trozamon/eecs373-project/doc/system.tex

\documentclass{article}

\usepackage{fullpage}
\usepackage{graphicx}
\usepackage{mathtools}

\begin{document}

\title{Green$^2$ Thumb System Design}
\author{
    Jason Leung\\
    Christopher Oo\\
    Jacob Perrin\\
    Alec Ten Harmsel
}
\date{}
\maketitle

\section{Power}
Power is provided by a bank of capacitors, charged by a solar cell. For the
purposes of planning, the following characteristics are assumed:

\begin{itemize}
    \item 66mW Power Draw: Nordic MCU + BLE Combo (33mW) and miscellaneous
        other power draws
    \item 10uA solar cell current
    \item 100ms runtime
\end{itemize}

\subsection{Maths}
Assuming 66mWs, or $6.6\cdot10^{-3}$J, of energy are needed to take a
measurement and send it, the amount of capacitance is given by: \begin{align*}
    U & = \frac{1}{2}CV^2\\
    1.32 \cdot 10^{-2} & = CV^2
\end{align*}

With 8V storage, we need 300$\mu$F of capacitance to be on the safe side.

The charging time can be found by manipulating the standard capacitor equation
thingy: \begin{align*}
    i & = C\frac{dv}{dt}\\
    it & = Cv\\
    t & = \frac{Cv}{i}
\end{align*}

It's about 141 seconds, or 2.35 minutes.

\begin{itemize}
    \item LMT84DCKT
\end{itemize}

\end{document}
