trozamon/eecs373-project/(list of files, cad)

Other CAD files:
enclosure/EnclosureBottom.CATPart
enclosure/EnclosureTop.CATPart
