trozamon/eecs373-project/kicad/power.kicad_pcb

## KiCad design kicad/power.kicad_pcb (2014-12-03)

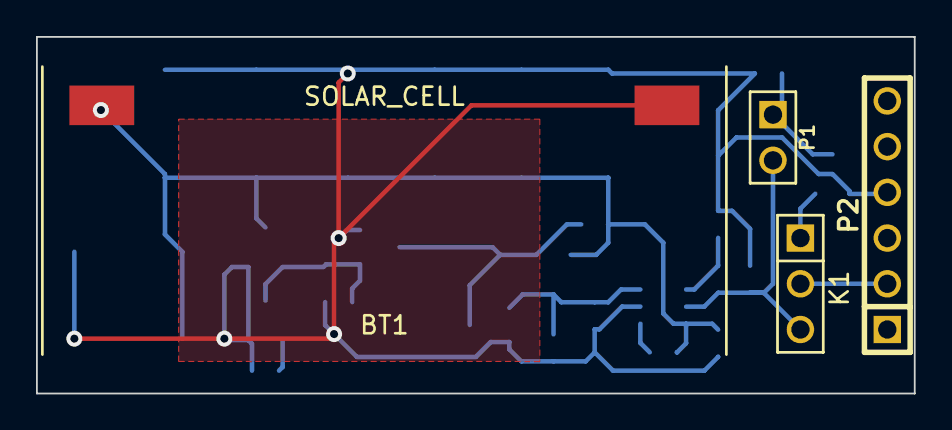
[picture p3: board power.kicad_pcb from above]

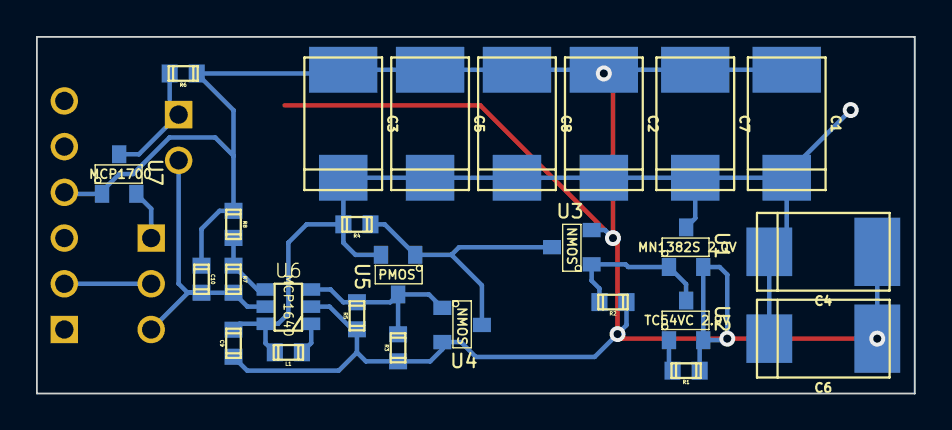
[picture p4: board power.kicad_pcb from below]

Board: 2 copper layers, 48.8 x 19.8 mm, 30 parts (26 on the bottom side), 12 nets.

Parts:
BT1: SOLAR_CELL; AM-1417
C1, C2, C3, C4, C5, C6, C7, C8: 100u; c_tant_D
C9: 4.7u; c_0603
C10: 10u; c_0603
K1: VSEL; PIN_ARRAY_3X1
L1: 4.7u; c_0603
P1: 1V8_EN; PIN_ARRAY_2X1
P2: CONN_6; PIN_ARRAY-6X1
R1: 1k; c_0603
R2: 100k; c_0603
R3, R4, R5, R6: 470k; c_0603
R7: 976k; c_0603
R8: 562k; c_0603
U1: MN1382S 2.0V; SOT23
U2: TC54VC 2.9V; SOT23
U3, U4: NMOS; SOT23
U5: PMOS; SOT23
U6: MCP1640; SOT23_6
U7: MCP1700; SOT23

Connections:
GND: BT1.2, C1.2, C2.2, C3.2, C4.2, C5.2, C6.2, C7.2, C8.2, C9.2, C10.2, P2.4, R1.2, R2.2, R3.2, R5.2, R6.2, R8.2, U1.2, U2.2, U3.2, U4.2, U6.2, U7.1
unnamed: C10.1, K1.3, P1.2, R7.1, U6.5
unnamed: K1.2, P2.2
unnamed: K1.1, U7.2
unnamed: R3.1, R5.1, U4.1, U5.3, U6.3
unnamed: L1.2, U6.1
unnamed: R7.2, R8.1, U6.4
unnamed: P1.1, R6.1, U7.3
unnamed: BT1.1, C1.1, C2.1, C3.1, C4.1, C5.1, C6.1, C7.1, C8.1, C9.1, L1.1, R4.1, U1.3, U5.2, U6.6
unnamed: R1.1, U2.1
unnamed: R2.1, U1.1, U2.3, U3.1
unnamed: R4.2, U3.3, U4.3, U5.1
