trozamon/eecs373-project/eagle/soil_mite_v1.brd

## EAGLE design eagle/soil_mite_v1.brd (2014-11-23)

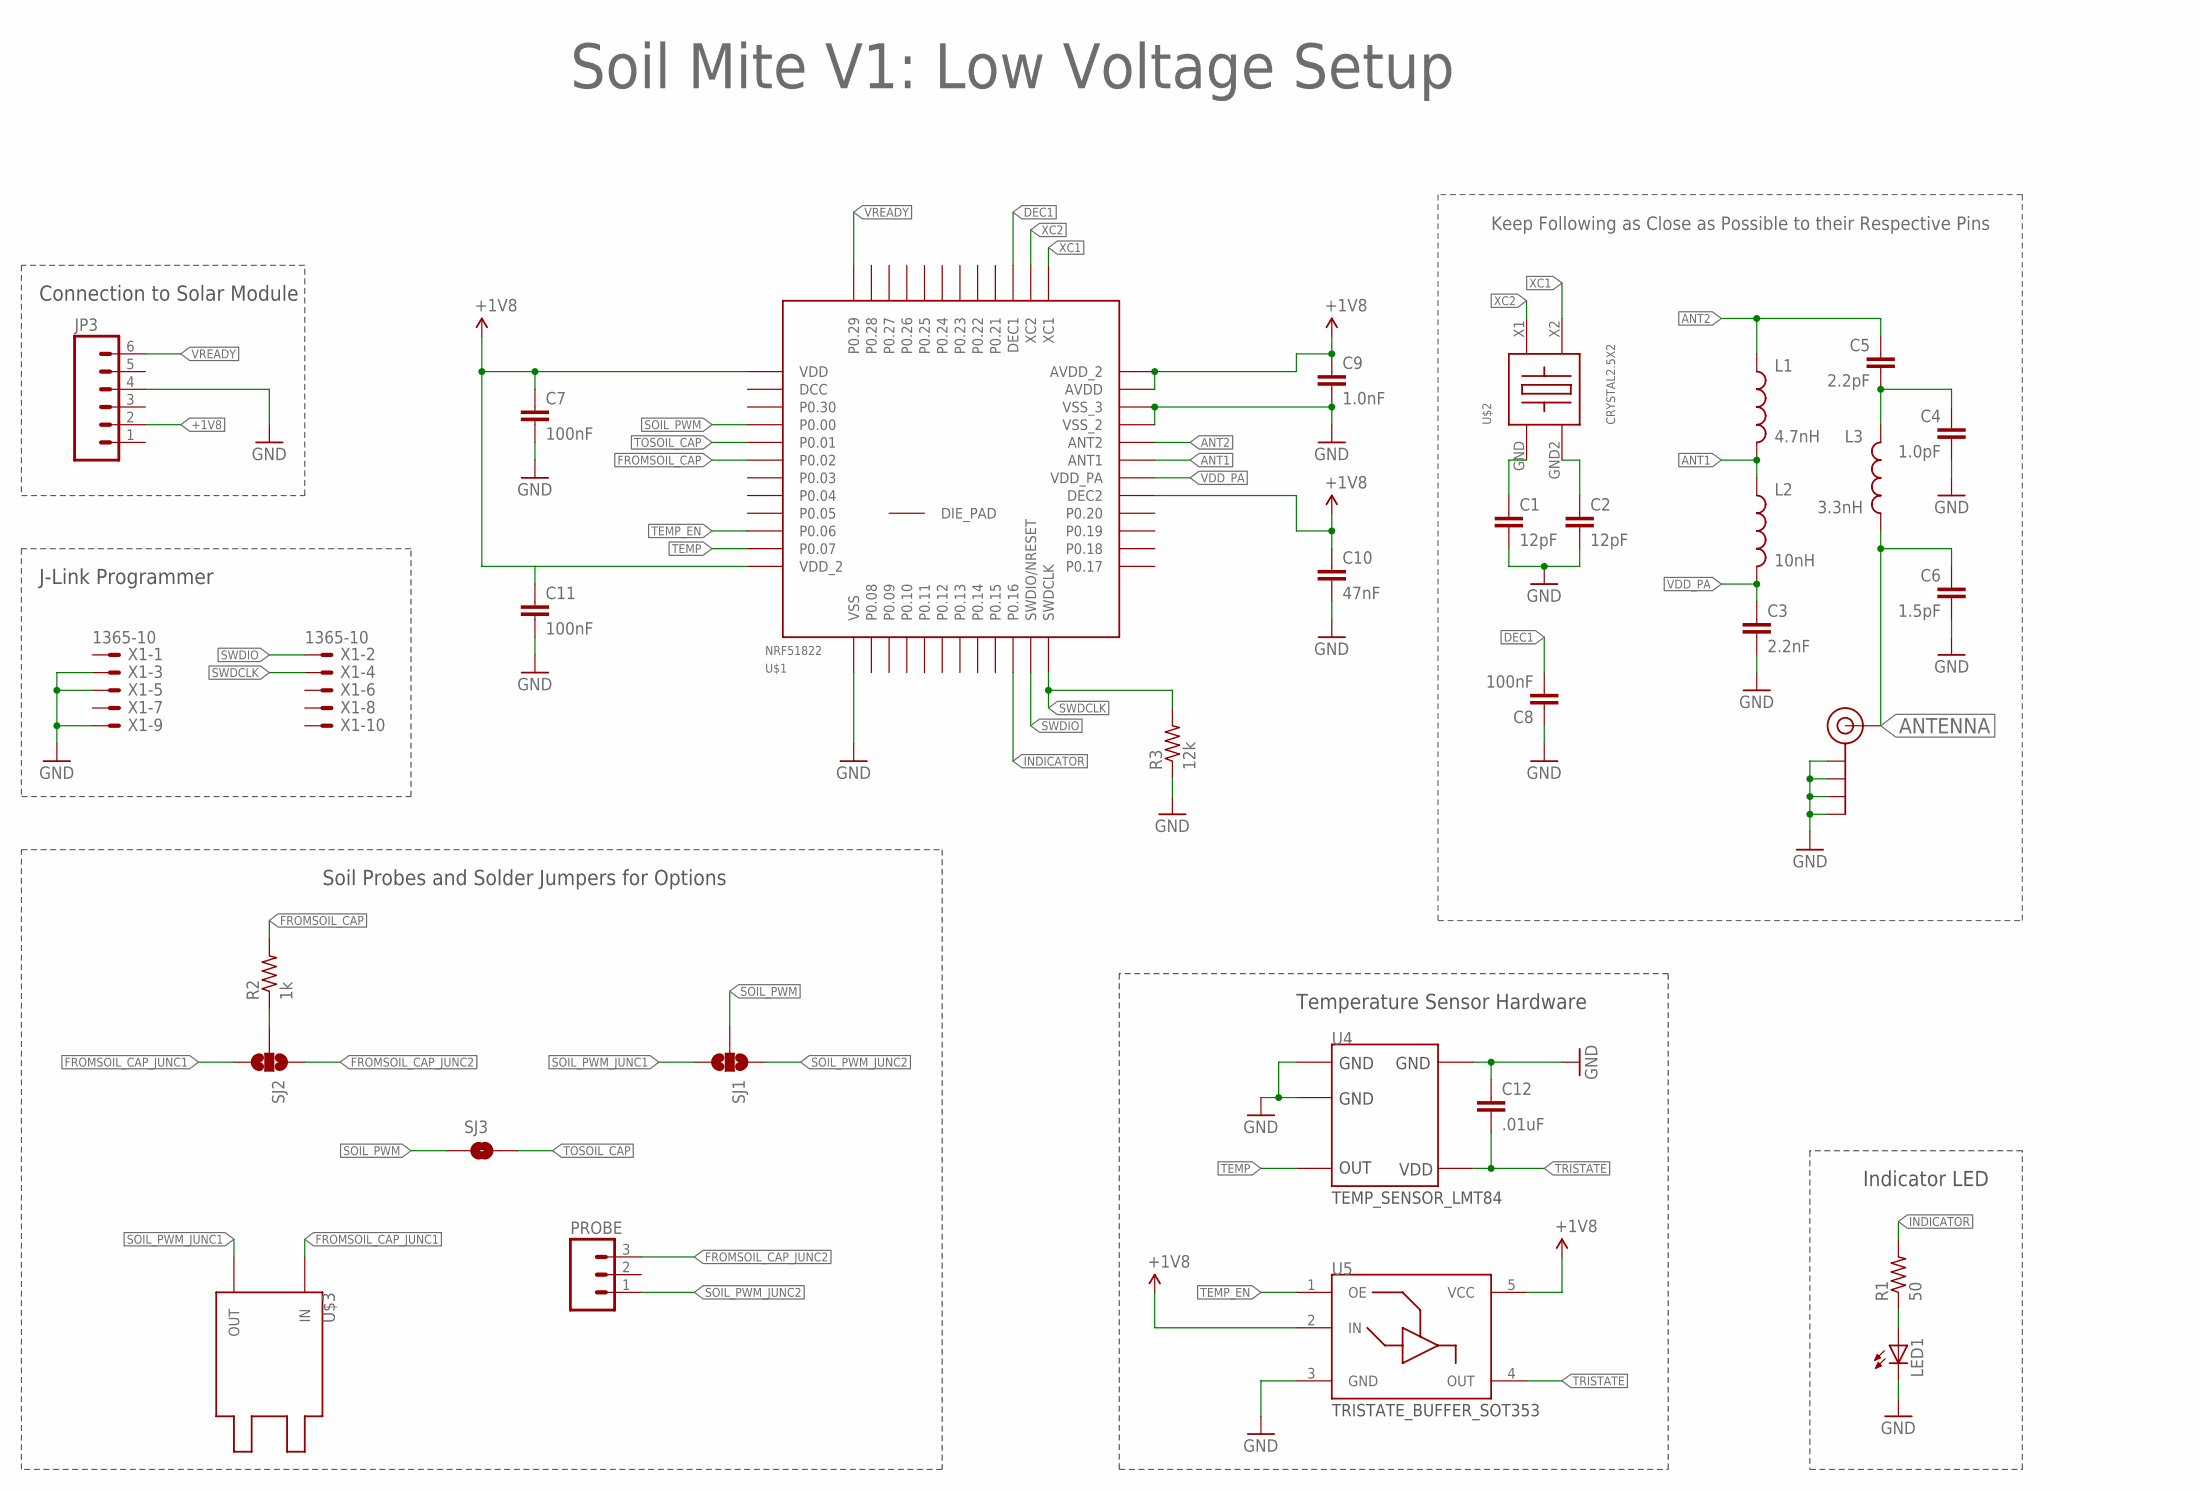
[picture p5: schematic soil_mite_v1.sch]

Parts:
C1, C2: 12pF; 0402-CAP
C3: 2.2nF; 0402-CAP
C4: 1.0pF; 0402-CAP
C5: 2.2pF; 0402-CAP
C6: 1.5pF; 0402-CAP
C7, C8, C11: 100nF; 0402-CAP
C9: 1.0nF; 0402-CAP
C10: 47nF; 0402-CAP
C12: .01uF; 0402-CAP
J$1: SMA_EDGE; SMA-EDGE
JP3: M06POLAR; MOLEX-1X6
L1: 4.7nH; C0402
L2: 10nH; C0402
L3: 3.3nH; C0402
LED1: JON_LIB_LEDCHIPLED_0603; JON_LIB_CHIPLED_0603
PROBE: M03PTH; 1X03
R1: 50; R0603
R2: 1k; R0603
R3: 12k; RCL_R0402
SJ1, SJ2: SOLDERJUMPER_2WAYT; SJ_2
SJ3: SOLDERJUMPERNO; SJ_2S-NO
U4: TEMP_SENSOR_LMT84; SOT353
U5: TRISTATE_BUFFER_SOT353; SOT353
U$1: NRF51822; QFN48
U$2: CRYSTAL2.5X2; 2.5X2MM
U$3: SOIL_PROBE_TOP_TOPOUT-IN; PROBE_LAYOUT_1_OUT-IN
X1: 1365-10

Connections:
+1V8: C7.1, C9.1, C10.1, C11.1, JP3.2, U5.2 (IN), U5.5 (VCC), U$1.1 (VDD), U$1.12 (VDD_2), U$1.29 (DEC2), U$1.35 (AVDD), U$1.36 (AVDD_2)
ANT1: L1.2, L2.1, U$1.31 (ANT1)
ANT2: C5.1, L1.1, U$1.32 (ANT2)
ANTENNA: C6.1, J$1.SIG (SIGNAL), L3.2
DEC1: C8.2, U$1.39 (DEC1)
FROMSOIL_CAP: R2.1, R2.2, SJ2.2, U$1.6 (P0.02)
FROMSOIL_CAP_JUNC1: SJ2.3, U$3.IN
FROMSOIL_CAP_JUNC2: PROBE.3, SJ2.1
GND: C1.2, C2.2, C3.2, C4.2, C6.2, C7.2, C8.1, C9.2, C10.2, C11.2, C12.1, J$1.GND@0 (GND), J$1.GND@1 (GND), J$1.GND@2 (GND), J$1.GND@3 (GND), JP3.4, LED1.C, R3.1, U4.1 (GND), U4.2 (GND), U4.5 (GND), U5.3 (GND), U$1.13 (VSS), U$1.33 (VSS_2), U$1.34 (VSS_3), X1.3, X1.5, X1.9
INDICATOR: R1.2, U$1.22 (P0.16)
unnamed: C1.1, U$2.GND
unnamed: C2.1, U$2.GND2
unnamed: LED1.A, R1.1
unnamed: C4.1, C5.2, L3.1
SOIL_PWM: SJ1.2, SJ3.1, U$1.4 (P0.00)
SOIL_PWM_JUNC1: SJ1.3, U$3.OUT
SOIL_PWM_JUNC2: PROBE.1, SJ1.1
SWDCLK: R3.2, U$1.24 (SWDCLK), X1.4
SWDIO: U$1.23 (SWDIO/NRESET), X1.2
TEMP: U4.3 (OUT), U$1.11 (P0.07)
TEMP_EN: U5.1 (OE), U$1.10 (P0.06)
TOSOIL_CAP: SJ3.2, U$1.5 (P0.01)
TRISTATE: C12.2, U4.4 (VDD), U5.4 (OUT)
VDD_PA: C3.1, L2.2, U$1.30 (VDD_PA)
VREADY: JP3.6, U$1.48 (P0.29)
XC1: U$1.37 (XC1), U$2.X2
XC2: U$1.38 (XC2), U$2.X1

Notes on the sheet:
Soil Mite V1: Low Voltage Setup
Keep Following as Close as Possible to their Respective Pins
Connection to Solar Module
J-Link Programmer
Soil Probes and Solder Jumpers for Options
Temperature Sensor Hardware
Indicator LED

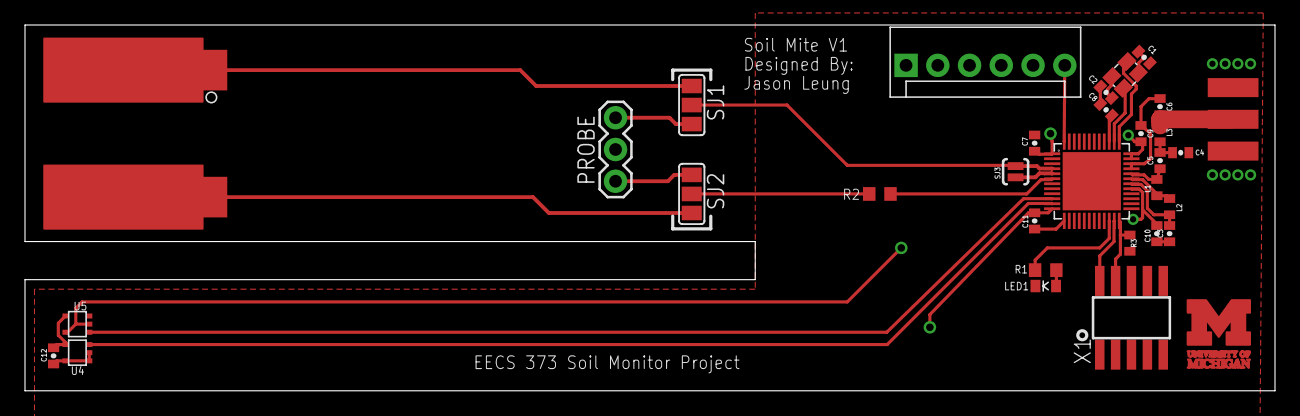
[picture p6: board soil_mite_v1.brd from above]

Board: 4 copper layers, 100.0 x 29.3 mm, 32 parts (0 on the bottom side), 27 nets.

Other parts of the board:
U$5: BLOCK-M-DOUBLE-STACKED-5MM_MASK
