trozamon/eecs373-project/(commit log)

2014-11-16 Add power circuit schematic
    [power.sch]
2014-11-21 Update power schematic
    [power.sch]
2014-11-21 Add temp sensor to system docs
2014-11-21 added completed schematic but incomplete board. if you need explanations of parts of the board feel free to ping me
    [soil_mite_v1.brd, soil_mite_v1.sch]
2014-11-21 Finish schematic, assigning footprints
    [power.sch]
2014-11-21 Finish power component to footprint mapping
2014-11-22 Finalize schematic
    [power.sch]
2014-11-22 Add initial power board design
    [power.kicad_pcb]
2014-11-23 updated files. need to understand new components
    [soil_mite_v1.brd, soil_mite_v1.sch]
2014-11-23 need to route board. 'layout' part done. need eagle professional to finish
    [soil_mite_v1.brd, soil_mite_v1.sch]
2014-11-23 finished layout. let me know if there are glaring errors
    [soil_mite_v1.brd, soil_mite_v1.sch]
2014-11-23 Add pull-downs to NMOS gates on power board
    [power.sch]
2014-11-23 Minor updates to power schematic and board
    [power.kicad_pcb, power.sch]
2014-11-23 finalized soil mite design. sending out for shipping
    [soil_mite_v1.brd, soil_mite_v1.sch]
2014-11-23 Add gerber stuffz
    [power.kicad_pcb]
2014-12-03 Redo power schematic
    [power.kicad_pcb, power.sch]
2014-12-03 Finish power schematic bugfixes
    [power.sch]
2014-12-03 Attach footprints to components
    [power.sch]
2014-12-03 Small fixes to schematic, netlist
    [power.sch]
2014-12-03 Layout PCB
    [power.kicad_pcb]
2014-12-03 Finish PCB layout
    [power.kicad_pcb]
2014-12-06 add ADC
2014-12-07 Add enclosure v1
    [EnclosureBottom.CATPart, EnclosureTop.CATPart]
2014-12-07 Add initial plotting script, reference power board build files
2014-12-07 Start temp sensor, disable prescaling
2014-12-08 Add soak data, R script for soak plot
    [soak.csv]
2014-12-08 Update EnclosureBottom
    [EnclosureBottom.CATPart]
